rodrigo-moliveira/SmartShowerArduino/docs/Implementation/outside2.jpg

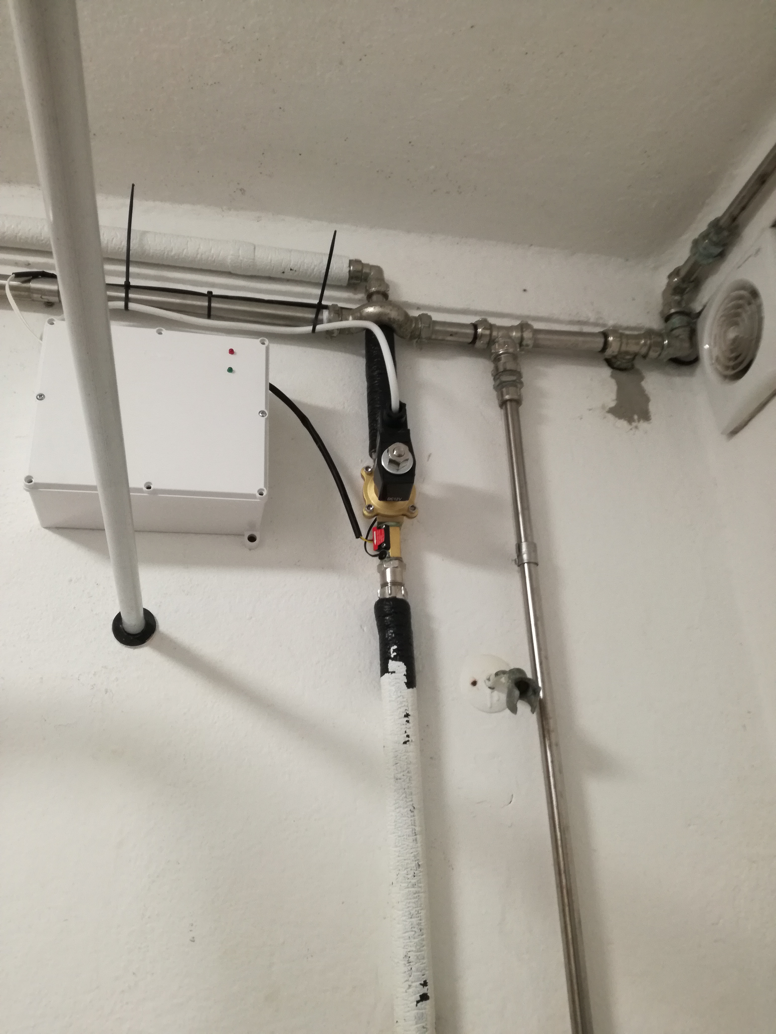
docs/Implementation/outside2.jpg
